sparkysparks42/BlindsESP32/PCB/manufacturing/2026-11-10-mask-fix/checks/drill-report.txt

Drill report for BlindsController.kicad_pcb
Created on 2026-11-10T20:34:02

Copper Layer Stackup:
    =============================================================
    L1 :  F.Cu                      front
    L2 :  B.Cu                      back

Drill file 'BlindsController-PTH.drl' contains
    plated through holes:
    =============================================================
    T1  0.400mm  0.0157"  (29 holes))
    T2  0.800mm  0.0315"  (10 holes))
    T3  0.900mm  0.0354"  (2 holes))
    T4  1.000mm  0.0394"  (58 holes))
    T5  1.190mm  0.0469"  (10 holes))
    T6  1.200mm  0.0472"  (4 holes))

    Total plated holes count 113

Drill file 'BlindsController-NPTH.drl' contains
    unplated through holes:
    =============================================================
    T1  2.700mm  0.1063"  (4 holes))

    Total unplated holes count 4
