sparkysparks42/BlindsESP32/PCB/BlindsController.kicad_pcb

## KiCad design PCB/BlindsController.kicad_pcb (2026-11-11)

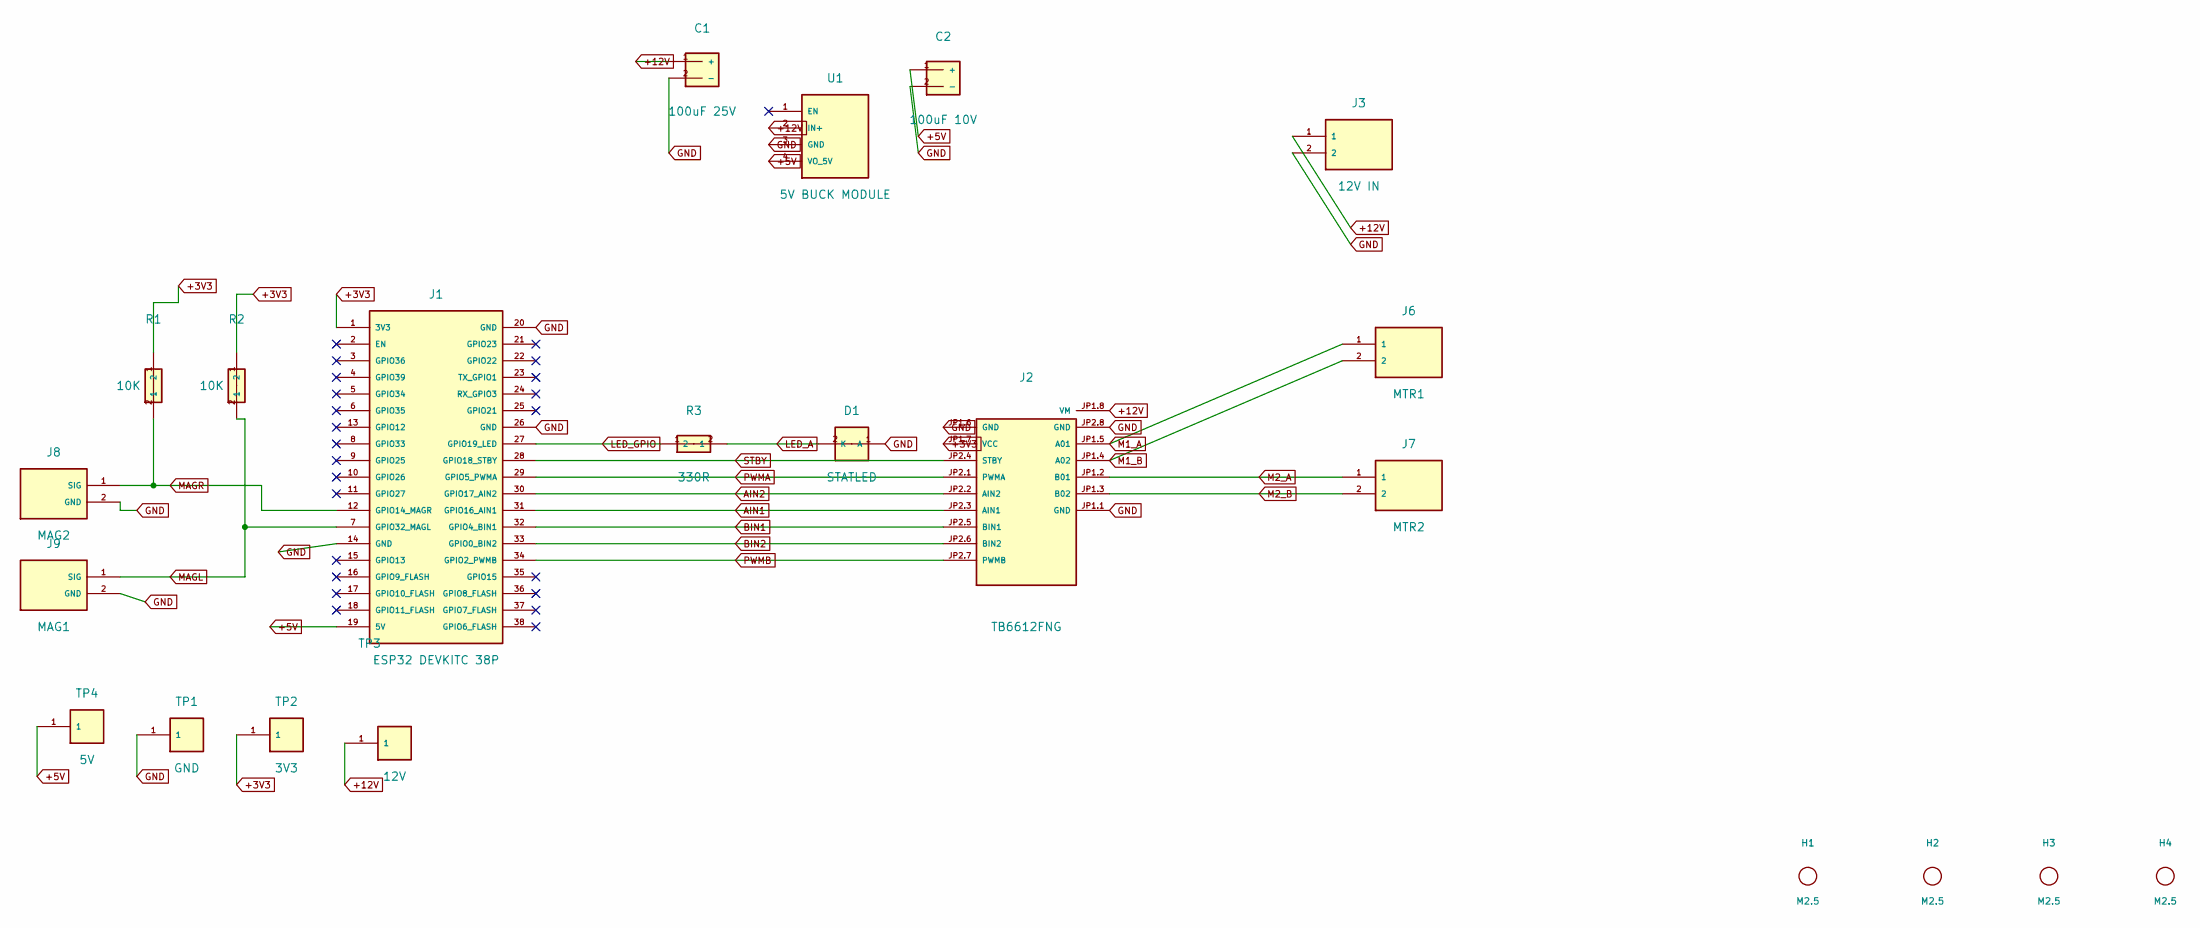
[picture p1: schematic BlindsController.kicad_sch, ESP32 Smart Blinds Controller]

Parts:
C1: 100uF 25V; CP_Radial_D6.3mm_P2.50mm
C2: 100uF 10V; CP_Radial_D6.3mm_P2.50mm
D1: STATLED; LED_D3.0mm
H1, H2, H3, H4: M2.5; MountingHole_2.7mm_M2.5
J1: ESP32 DEVKITC 38P; Carrier_J1
J2: TB6612FNG; Carrier_J2
J3: 12V IN; Molex_KK-254_AE-6410-02A_1x02_P2.54mm_Vertical
J6: MTR1; Molex_KK-254_AE-6410-02A_1x02_P2.54mm_Vertical
J7: MTR2; Molex_KK-254_AE-6410-02A_1x02_P2.54mm_Vertical
J8: MAG2; Molex_KK-254_AE-6410-02A_1x02_P2.54mm_Vertical
J9: MAG1; Molex_KK-254_AE-6410-02A_1x02_P2.54mm_Vertical
R1, R2: 10K; R_Axial_DIN0207_L6.3mm_D2.5mm_P7.62mm_Horizontal
R3: 330R; R_Axial_DIN0207_L6.3mm_D2.5mm_P7.62mm_Horizontal
TP1: GND; TestPoint_THTPad_D2.5mm_Drill1.2mm
TP2: 3V3; TestPoint_THTPad_D2.5mm_Drill1.2mm
TP3: 12V; TestPoint_THTPad_D2.5mm_Drill1.2mm
TP4: 5V; TestPoint_THTPad_D2.5mm_Drill1.2mm
U1: 5V BUCK MODULE; PinHeader_1x04_P2.54mm_Vertical

Connections:
+3V3: J1.1 (3V3), J2.JP1.7 (VCC), R1.1, R2.1, TP2.1
+5V: C2.1 (+), J1.19 (5V), TP4.1, U1.4 (VO_5V)
+12V: C1.1 (+), J2.JP1.8 (VM), J3.1, TP3.1, U1.2 (IN+)
AIN1: J1.31 (GPIO16_AIN1), J2.JP2.3 (AIN1)
AIN2: J1.30 (GPIO17_AIN2), J2.JP2.2 (AIN2)
BIN1: J1.32 (GPIO4_BIN1), J2.JP2.5 (BIN1)
BIN2: J1.33 (GPIO0_BIN2), J2.JP2.6 (BIN2)
GND: C1.2 (-), C2.2 (-), D1.1 (K), J1.14 (GND), J1.20 (GND), J1.26 (GND), J2.JP1.1 (GND), J2.JP1.6 (GND), J2.JP2.8 (GND), J3.2, J8.2 (GND), J9.2 (GND), TP1.1, U1.3 (GND)
LED_A: D1.2 (A), R3.2
LED_GPIO: J1.27 (GPIO19_LED), R3.1
M1_A: J2.JP1.5 (A01), J6.1
M1_B: J2.JP1.4 (A02), J6.2
M2_A: J2.JP1.2 (B01), J7.1
M2_B: J2.JP1.3 (B02), J7.2
MAGL: J1.7 (GPIO32_MAGL), J9.1 (SIG), R2.2
MAGR: J1.12 (GPIO14_MAGR), J8.1 (SIG), R1.2
PWMA: J1.29 (GPIO5_PWMA), J2.JP2.1 (PWMA)
PWMB: J1.34 (GPIO2_PWMB), J2.JP2.7 (PWMB)
STBY: J1.28 (GPIO18_STBY), J2.JP2.4 (STBY)

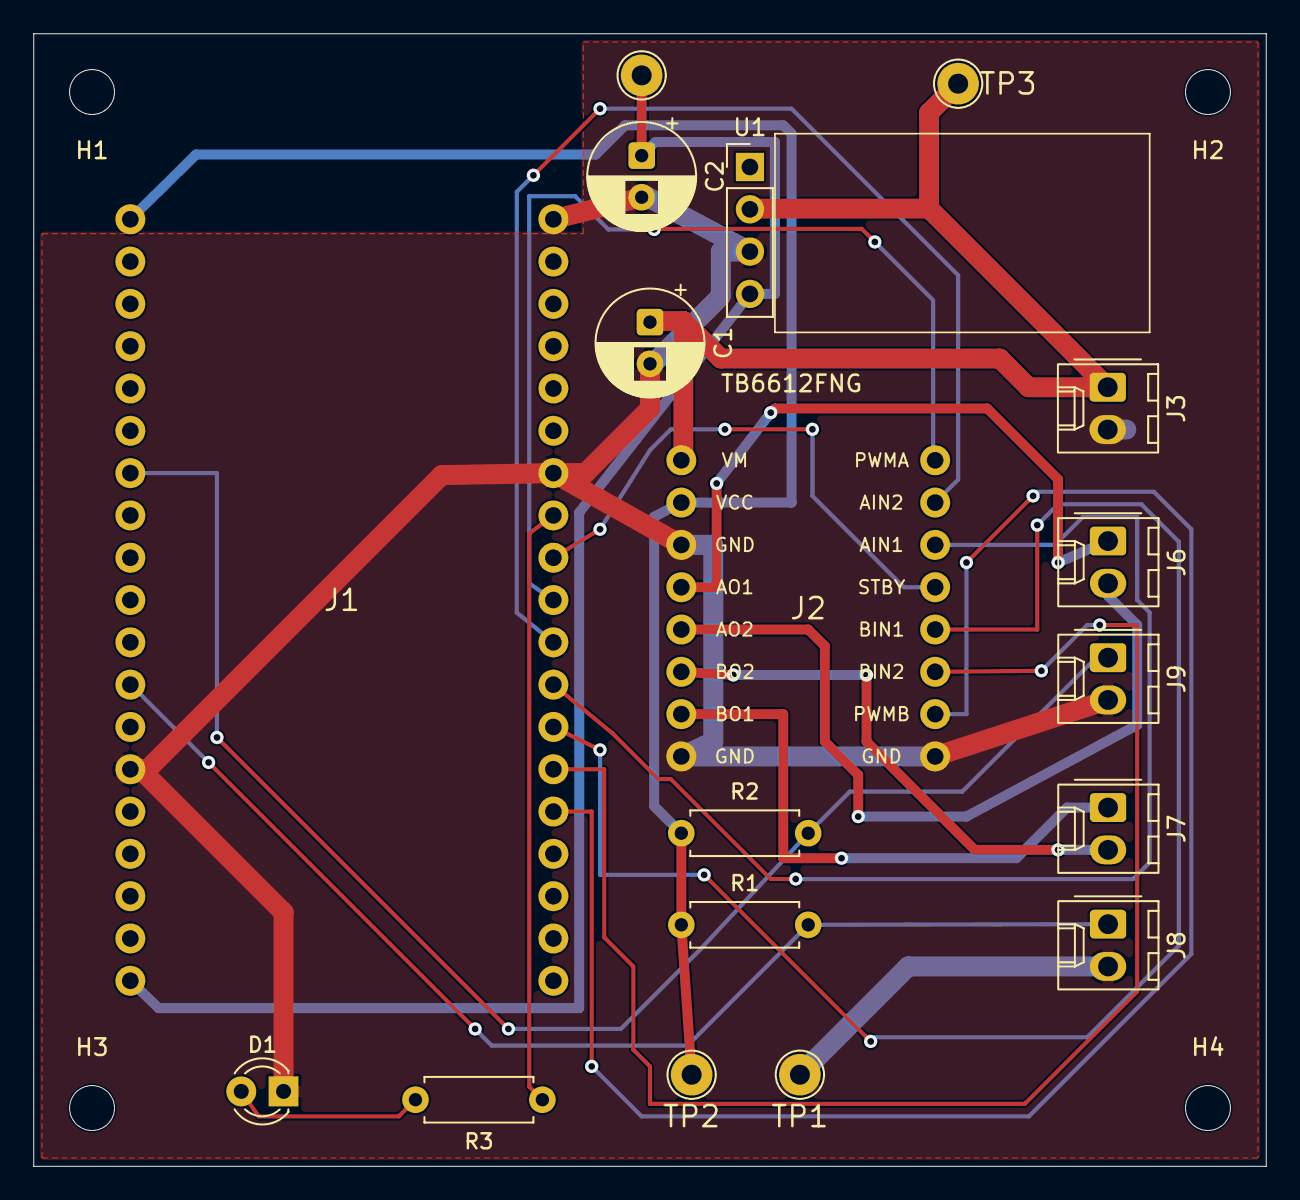
[picture p2: board BlindsController.kicad_pcb from above]

Board: 2 copper layers, 74.0 x 68.0 mm, 22 parts (0 on the bottom side), 19 nets.
