sparkysparks42/BlindsESP32/(commit log)

2026-11-04 ESP32 smart blinds controller for Arduino Cloud
    Controls motorised blinds from the Arduino Cloud dashboard using an ESP32,
    a TB6612FNG motor driver and magnetic reed switch stall detection.
    [BlindsESP32_apr16a.ino, motor_driver.cpp, motor_driver.h]
2026-11-04 Add Tinkercad CAD link to README
2026-11-04 Tidy duplicated GPIO strapping-pin note in README
2026-11-11 Add reviewed KiCad PCB project and ordered fabrication release
    [BlindsController-B_Cu.gbl, BlindsController-B_Mask.gbs, BlindsController-B_Silkscreen.gbo, BlindsController-Edge_Cuts.gm1, BlindsController-F_Cu.gtl, BlindsController-F_Mask.gts, BlindsController-F_Silkscreen.gto, BlindsController-NPTH.drl]
2026-11-11 Fix solder mask openings and use standard component footprints
    [BlindsController-B_Cu.gbl, BlindsController-B_Mask.gbs, BlindsController-B_Silkscreen.gbo, BlindsController-Edge_Cuts.gm1, BlindsController-F_Cu.gtl, BlindsController-F_Mask.gts, BlindsController-F_Silkscreen.gto, BlindsController-NPTH.drl]
